anakom-suvonvorn/FPGA-Tetris/cad/cover/out/preview_under.png

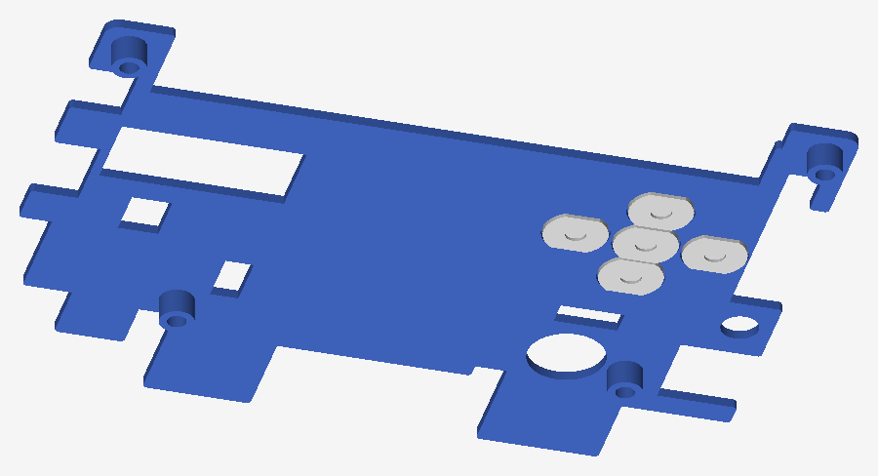
cad/cover/out/preview_under.png
