anakom-suvonvorn/FPGA-Tetris/game/screenshot_versus.png

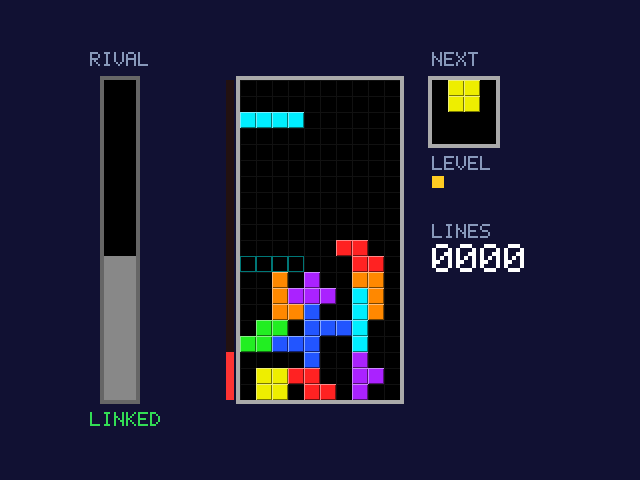
game/screenshot_versus.png
