anakom-suvonvorn/FPGA-Tetris/game/screenshot_win.png

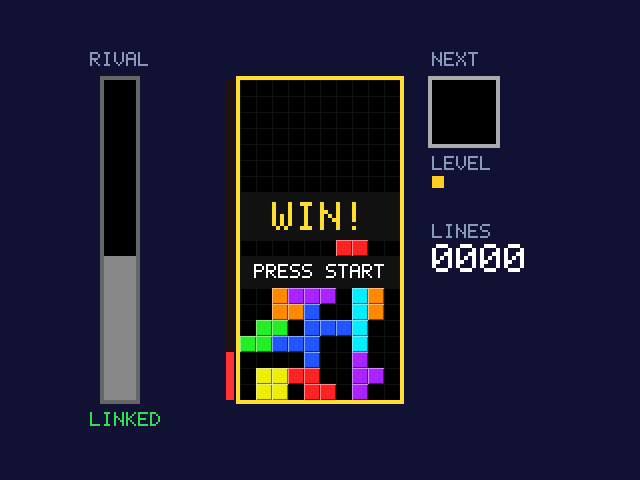
game/screenshot_win.png
