anakom-suvonvorn/FPGA-Tetris/sim/out/preview_all_patterns.png

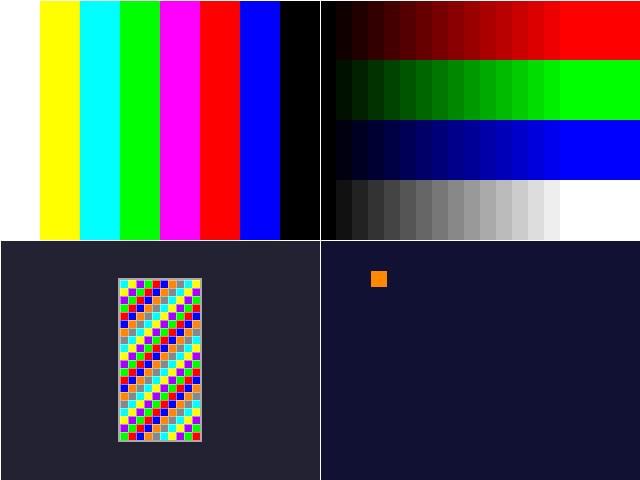
sim/out/preview_all_patterns.png
