anakom-suvonvorn/FPGA-Tetris/cad/cover/out/cover.3mf

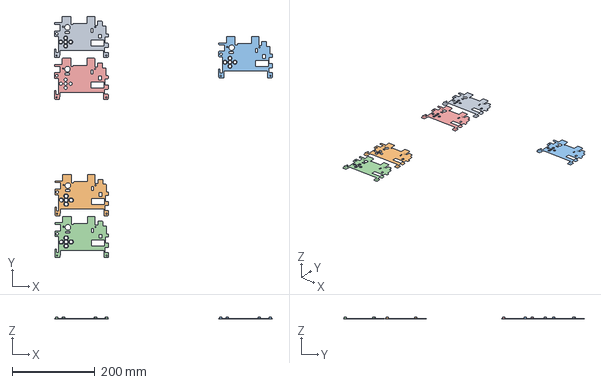
[picture p6: CAD file, 2026-10-30]
cad/cover/out/cover.3mf
527.0 x 583.4 x 6.00 mm
edge_cover x 5
