anakom-suvonvorn/FPGA-Tetris/cad/cover/out/button_caps.stl

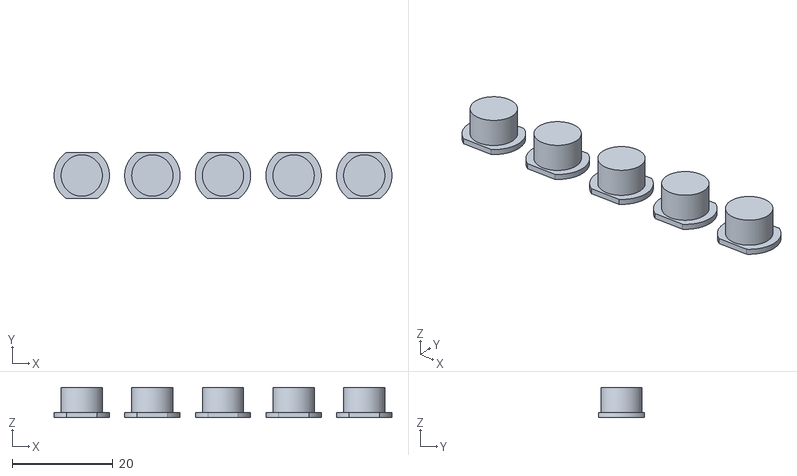
[picture p7: CAD file, 2026-10-30]
cad/cover/out/button_caps.stl
67.0 x 9.20 x 6.00
