anakom-suvonvorn/FPGA-Tetris/cad/cover/out/cover_labels.stl

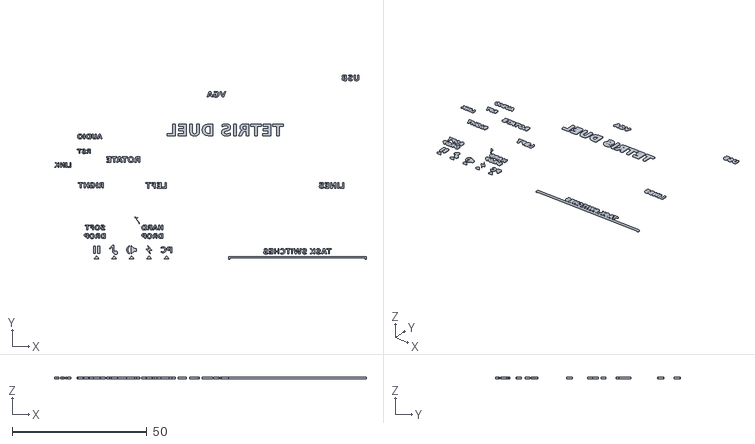
[picture p8: CAD file, 2026-10-29]
cad/cover/out/cover_labels.stl
115.6 x 68.4 x 0.6
