anakom-suvonvorn/FPGA-Tetris/cad/cover/out/cover_body.stl

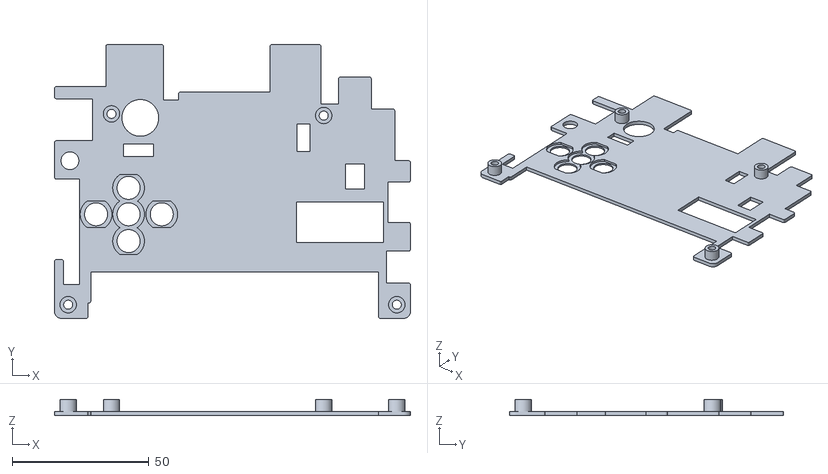
[picture p9: CAD file, 2026-10-29]
cad/cover/out/cover_body.stl
130.0 x 100.0 x 6.00
