anakom-suvonvorn/FPGA-Tetris/cad/cover/out/spacers_m3.stl

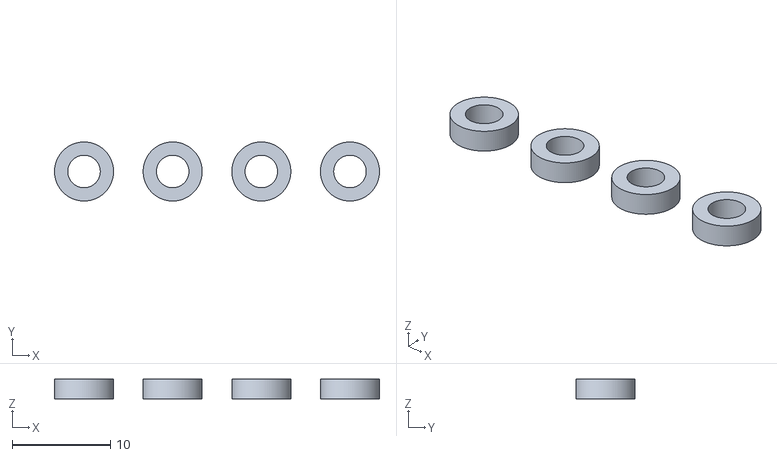
[picture p10: CAD file, 2026-10-29]
cad/cover/out/spacers_m3.stl
33.0 x 6.00 x 2.00
