anakom-suvonvorn/FPGA-Tetris/cad/cover/out/template_1to1.pdf

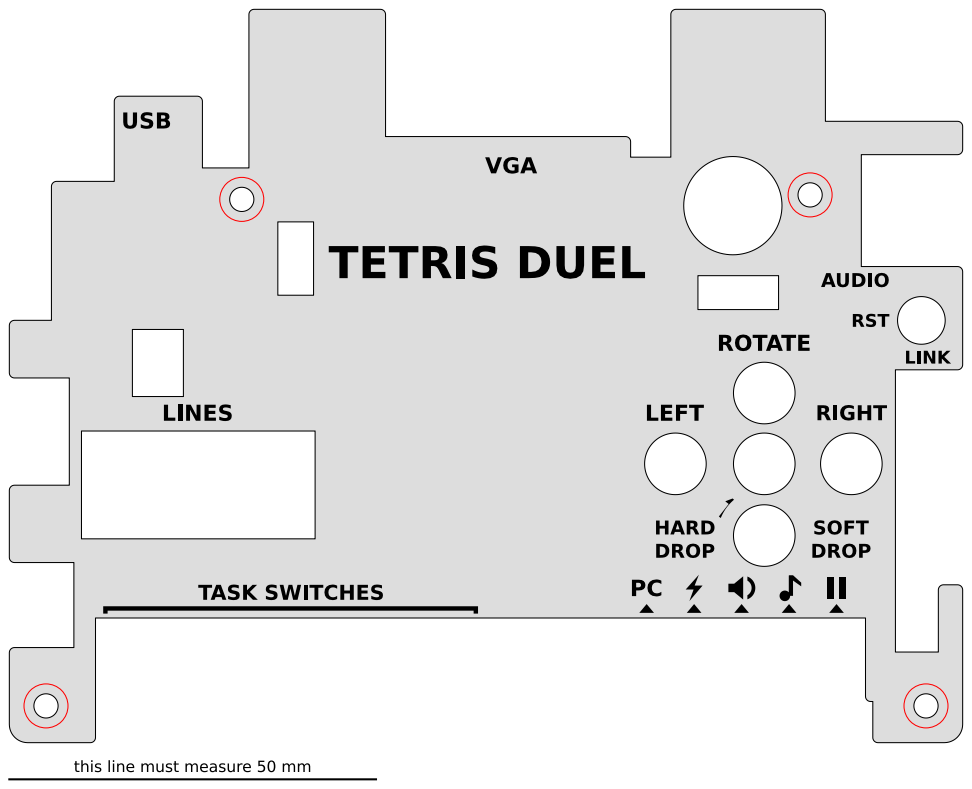
[picture p11: page 1]

this line must measure 50 mm
