anakom-suvonvorn/FPGA-Tetris/game/top_tetris.vhd

-- ============================================================================
-- top_tetris.vhd  -  Tetris Duel: versus Tetris on two boards (versus core)
--
-- Load the same design into both boards and connect them with 3 wires on J5
-- (see game\README.md). With no second board it plays single player.
--
-- Controls (the 5 push buttons form a cross):
--
--              SW16 rotate
--   SW14 left  SW18 hard drop  SW20 right       (hold left/right to keep moving)
--              SW23 soft drop (hold)
--
--   SW18 (centre) also starts a round; in versus it starts both boards.
--   After a game ends the buttons can't start a new one for 1.5 s (so a
--   hard drop pressed just as the rival loses doesn't start the next round).
--
-- Slide switches: settings on the far right of the row of 16,
--   SW2 pause (rightmost)   SW4 music on   SW5 sound effects on
--   SW7 link to the PC over USB instead of the J5 cable (test with
--       tools\fake_opponent.py, the PC plays the other board)
--   All slide switches go through switch_filter (bounce removed).
--
-- Versus rules: clearing 2 / 3 / 4 lines sends 1 / 2 / 4 garbage lines.
-- Lines you clear first cancel garbage waiting for you (red meter left of
-- the field). Last one standing wins.
--
-- Structure (top-down design):
--   top_tetris
--     +-- vga_sync       640x480 timing, frame_tick 60 times a second
--     +-- tetris_input   buttons -> action pulses (debounce, auto-repeat)
--     +-- tetris_core    the game rules and state (incl. garbage, win/lose)
--     +-- versus_link    messages to/from the other board (uart_tx/uart_rx)
--     +-- tetris_render  game state -> pixel colours (uses text_layer)
--     +-- tetris_sound   music + effects -> audio jack, buzzer
--     +-- seg7_scan      lines on the 7-segment display
-- ============================================================================
library ieee;
use ieee.std_logic_1164.all;
use ieee.numeric_std.all;
use work.common_pkg.all;
use work.tetris_pkg.all;

entity top_tetris is
  generic (
    DEBOUNCE_CYCLES   : integer := 250_000;       -- 5 ms; testbenches use less
    LINK_CLKS_PER_BIT : integer := CLKS_PER_BIT;  -- 115200 baud
    SW_TICK_CYCLES    : integer := 50_000         -- switch_filter sample: 1 ms
  );
  port (
    clk       : in  std_logic;                       -- H11
    btn_left  : in  std_logic;                       -- J14 SW14, left of the cross
    btn_rot   : in  std_logic;                       -- J13 SW16, top
    btn_hard  : in  std_logic;                       -- J12 SW18, centre
    btn_soft  : in  std_logic;                       -- L13 SW23, bottom
    btn_right : in  std_logic;                       -- J11 SW20, right
    sw_pause  : in  std_logic;                       -- K11 SW2
    sw_music  : in  std_logic;                       -- M11 SW4
    sw_sfx    : in  std_logic;                       -- N14 SW5
    sw_usb    : in  std_logic;                       -- N10 SW7
    link_tx   : out std_logic;                       -- L14 J5 pin 5
    link_rx   : in  std_logic;                       -- M13 J5 pin 6
    usb_tx    : out std_logic;                       -- F2  to the PC
    usb_rx    : in  std_logic;                       -- G1  from the PC
    audio_l   : out std_logic;                       -- A13
    audio_r   : out std_logic;                       -- B13
    buzzer    : out std_logic;                       -- B14 (needs jumper J6)
    vga_r     : out std_logic_vector(3 downto 0);
    vga_g     : out std_logic_vector(3 downto 0);
    vga_b     : out std_logic_vector(3 downto 0);
    vga_hs    : out std_logic;
    vga_vs    : out std_logic;
    seg_n     : out std_logic_vector(7 downto 0);
    dig       : out std_logic_vector(3 downto 0)
  );
end entity;

architecture rtl of top_tetris is
  -- video timing
  signal x, y        : unsigned(9 downto 0);
  signal video_on    : std_logic;
  signal hs, vs      : std_logic;
  signal frame_tick  : std_logic;

  -- inputs
  signal btns        : std_logic_vector(4 downto 0);
  signal sw_raw, sw_s : std_logic_vector(3 downto 0);
  signal pause_s, music_s, sfx_s, usb_s : std_logic;
  signal a_left, a_right, a_rot, a_soft, a_hard : std_logic;

  -- game state
  signal occ         : occ_field_t;
  signal colf        : col_field_t;
  signal cur_shape   : shape_t;
  signal cur_color   : color_t;
  signal cur_x       : xpos_t;
  signal cur_y       : ypos_t;
  signal ghost_y     : ypos_t;
  signal next_shape  : shape_t;
  signal next_color  : color_t;
  signal playing     : std_logic;
  signal can_start   : std_logic;
  signal game_over   : std_logic;
  signal lines_bcd   : std_logic_vector(15 downto 0);
  signal level       : integer range 0 to 15;
  signal clear_evt   : std_logic;
  signal clear_n     : integer range 0 to 4;

  -- versus
  signal link_ok     : std_logic;
  signal rx_line, tx_line : std_logic;
  signal start_out, lost_out, garb_out : std_logic;
  signal garb_out_n  : integer range 0 to 31;
  signal got_start, got_lost, got_garb : std_logic;
  signal got_n       : integer range 0 to 31;
  signal height      : integer range 0 to 20;
  signal opp_height  : integer range 0 to 20;
  signal pending     : integer range 0 to 31;
  signal result      : integer range 0 to 4;

  signal audio       : std_logic;
  signal g3, g2, g1, g0 : glyph_t;
begin

  u_sync : entity work.vga_sync
    port map (clk => clk, pix_en => open, x => x, y => y, video_on => video_on,
              hsync => hs, vsync => vs, frame_tick => frame_tick);

  -- buttons, in the order tetris_input expects
  btns <= btn_hard & btn_soft & btn_rot & btn_right & btn_left;

  -- slide switches are outside the clock's world and they bounce:
  -- synchronise and clean them
  sw_raw <= sw_usb & sw_sfx & sw_music & sw_pause;
  u_sw : entity work.switch_filter
    generic map (N => 4, TICK_CYCLES => SW_TICK_CYCLES)
    port map (clk => clk, sw_in => sw_raw, sw_out => sw_s);
  pause_s <= sw_s(0);
  music_s <= sw_s(1);
  sfx_s   <= sw_s(2);
  usb_s   <= sw_s(3);

  u_input : entity work.tetris_input
    generic map (DEBOUNCE_CYCLES => DEBOUNCE_CYCLES)
    port map (clk => clk, frame_tick => frame_tick, btn => btns,
              act_left => a_left, act_right => a_right, act_rot => a_rot,
              act_soft => a_soft, act_hard => a_hard);

  u_core : entity work.tetris_core
    port map (
      clk => clk, frame_tick => frame_tick, pause => pause_s,
      act_left => a_left, act_right => a_right, act_rot => a_rot,
      act_soft => a_soft, act_hard => a_hard,
      versus => link_ok, start_in => got_start, garb_in => got_garb, garb_in_n => got_n,
      opp_lost => got_lost, start_out => start_out, lost_out => lost_out,
      garb_out => garb_out, garb_out_n => garb_out_n,
      height => height, pending => pending, result => result,
      occ => occ, colf => colf,
      cur_shape => cur_shape, cur_color => cur_color, cur_x => cur_x, cur_y => cur_y,
      ghost_y => ghost_y, next_shape => next_shape, next_color => next_color,
      playing => playing, can_start => can_start, game_over => game_over,
      lines_bcd => lines_bcd, level => level,
      clear_evt => clear_evt, clear_n => clear_n
    );

  -- the link: listen on the J5 cable, or on the USB serial port when SW7 is
  -- on. Send on both (whoever isn't listening just ignores it).
  rx_line <= usb_rx when usb_s = '1' else link_rx;
  link_tx <= tx_line;
  usb_tx  <= tx_line;

  u_link : entity work.versus_link
    generic map (CLKS_PER_BIT => LINK_CLKS_PER_BIT)
    port map (
      clk => clk, frame_tick => frame_tick, rx => rx_line, tx => tx_line,
      send_start => start_out, send_lost => lost_out,
      send_garbage => garb_out, garbage_n => garb_out_n, my_height => height,
      got_start => got_start, got_lost => got_lost, got_garbage => got_garb,
      got_n => got_n, opp_height => opp_height, link_ok => link_ok
    );

  u_render : entity work.tetris_render
    port map (
      clk => clk, x => x, y => y, video_on => video_on, hsync => hs, vsync => vs,
      occ => occ, colf => colf,
      cur_shape => cur_shape, cur_color => cur_color, cur_x => cur_x, cur_y => cur_y,
      ghost_y => ghost_y, next_shape => next_shape, next_color => next_color,
      playing => playing, can_start => can_start, game_over => game_over, paused => pause_s, level => level,
      lines_bcd => lines_bcd, result => result, pending => pending,
      opp_height => opp_height, link_ok => link_ok,
      vga_r => vga_r, vga_g => vga_g, vga_b => vga_b, vga_hs => vga_hs, vga_vs => vga_vs
    );

  u_sound : entity work.tetris_sound
    port map (
      clk => clk, frame_tick => frame_tick, music_on => music_s, sfx_on => sfx_s,
      playing => playing, level => level, clear_evt => clear_evt, clear_n => clear_n,
      garb_evt => got_garb, result => result, audio => audio, buzz => buzzer
    );
  audio_l <= audio;
  audio_r <= audio;

  -- lines cleared, 4 decimal digits
  g3 <= hex7(lines_bcd(15 downto 12));
  g2 <= hex7(lines_bcd(11 downto 8));
  g1 <= hex7(lines_bcd(7 downto 4));
  g0 <= hex7(lines_bcd(3 downto 0));

  u_seg : entity work.seg7_scan
    port map (clk => clk, d3 => g3, d2 => g2, d1 => g1, d0 => g0,
              dp => "0000", seg_n => seg_n, dig => dig);

end architecture;
