anakom-suvonvorn/FPGA-Tetris/(commit log)

2026-10-19 Start cool-down after a game (1.5 s), debounced slide switches (switch_filter + PULLDOWN), settings moved to the right (USB link SW22 -> SW7)
2026-10-29 Add 3D-printable board cover with labels and button extenders (cad/cover)
    make_cover.py generates a cover plate for the EDGE Spartan-7 board that
    works for main and chaos: labels for the 5 push buttons, one opening for
    the 16 slide switches with TASK SWITCHES and settings icons (PC, CHAOS,
    sound, music, pause), and openings for the connectors and tall parts.
    Outputs in out/: cover.3mf (plate + label inlay), STLs, 8 mm button
    extenders, M3 spacers and a 1:1 paper template.
    [button_caps.stl, cover.3mf, cover_body.stl, cover_labels.stl, spacers_m3.stl]
2026-10-30 Cover: 8.2 mm button extender knobs (0.1 mm gap), 4 mm above the plate
    [button_caps.stl, cover.3mf]
2026-10-30 Adjust printing parameters
    [cover.3mf]
